QuantumInstruments/AccQCO2_1-1/AccQCO2_1-1_BoM.xlsx

Enervative AccQ CO2 Board BoM V1.1 - 2026-10-26
Designator | Quantity | Value | Footprint | Mount Type | PartNo | Manufacturer | Description | Comments
C1, C3, C9, C10, C11 | 5 | 100nF 50V X7R | C_0805_2012Metric_Pad1.18x1.45mm_HandSolder | smt |  | Generic | MLCC Capacitor X7R
C2 | 1 | 100nF 16V X7R | C_0402_1005Metric_Pad0.74x0.62mm_HandSolder | smt |  | Generic | MLCC Capacitor X7R | Note small footprint Part equivalent to Kyocera AVX KGM05AR71C104KN
C4, C5, C7 | 3 | 100uF 10V | CP_EIA-6032-28_Kemet-C_HandSolder | smt |  | Generic | Tantalum Capacitor | 10% or 20% Tolerance acceptable
C6, C8 | 2 | 100uF 6.3V | CP_EIA-3528-21_Kemet-B_HandSolder | smt |  | Generic | Tantalum Capacitor | 10% or 20% Tolerance acceptable
FB1 | 1 | 0.8A | R_0603_1608Metric | smt | MPZ1608S102ATA00 | TDK | Ferrite bead
J1 | 1 | RJ45 JACK | AMPHENOL_54602-908LF | tht | 54602-908LF | Amphenol | RJ45 connector, 8P8C w/o LED & Magnetics
J2 | 1 | Barrel_Jack_Switch | CUI_PJ-102 | tht | PJ-102A | Same Sky | DC Barrel Jack with an internal switch | China sourced equivalent OK
R1, R3 | 2 | 10K | R_1206_3216Metric_Pad1.30x1.75mm_HandSolder | smt |  | Generic | Resistor 1% 0.25W
R2, R4 | 2 | 110R | R_1206_3216Metric_Pad1.30x1.75mm_HandSolder | smt |  | Generic | Resistor 1% 0.25W
R5 | 1 | 1K | R_1206_3216Metric_Pad1.30x1.75mm_HandSolder | smt |  | Generic | Resistor 1% 0.25W
RN1 | 1 | 4 x 620R | R_Array_Convex_4x0603 | smt | YC164-JR-07620RL | Yageo | ±5% 62.5mW Power Per Element Isolated 4 Resistor Network | China sourced equivalent OK
U1 | 1 | PCA9615DP | TSSOP-10_3x3mm_P0.5mm | smt | PCA9615DPZ | NXP | Buffer, ReDriver 2 Channel 400kHz 10-TSSOP
U2 | 1 | SHT45-AD1F-R2 | SHT4X | smt | SHT45-AD1F-R2 | Sensirion | Digital Relative Humidity Temperature Sensor, ±1.0 %RH, ±0.1 °C, Ultra-Low-Power, with filtermembrane
U3 | 1 | TLV1117-33CKVURG3 | TO-252-2 | smt | TLV1117-33CKVURG3 | Texas | LDO 800mA Linear Regulator, Fixed Output, TO-252 | Alternative Parts: Diodes Incorporated: AZ1117D-3.3TRE1 STMicroelectronics: LD1117DT33TR or LD1117V33 ON Semiconductor: NCP1117DT33G
U4 | 1 | SCD43 | Sensirion_SCD4x-1EP_10.1x10.1mm_P1.25mm_EP4.8x4.8mm | smt | SCD43-D-R2 | Sensirion | Photoacoustic CO2 sensor, 40 000 ppm, I2C, 2.4-5.5 V, Base accuracy 400 - 2000 ppm
U5 | 1 | 256x8 ROM | IC_M24128-BFMH6TG | smt | M24C02-FMH6TG | ST Microelectronics | I2C Serial EEPROM, 2Kb, UFDFPN5
Total Parts | 25 |  | Total number of types | 16
Total SMT | 23 |  | Total SMT types | 14
Total THT | 2 |  | Total THT types | 2
