QuantumInstruments/AccQCO2_1-1/AccQCO2_1-1.kicad_pcb

## KiCad design AccQCO2_1-1.kicad_pcb (2026-10-29)

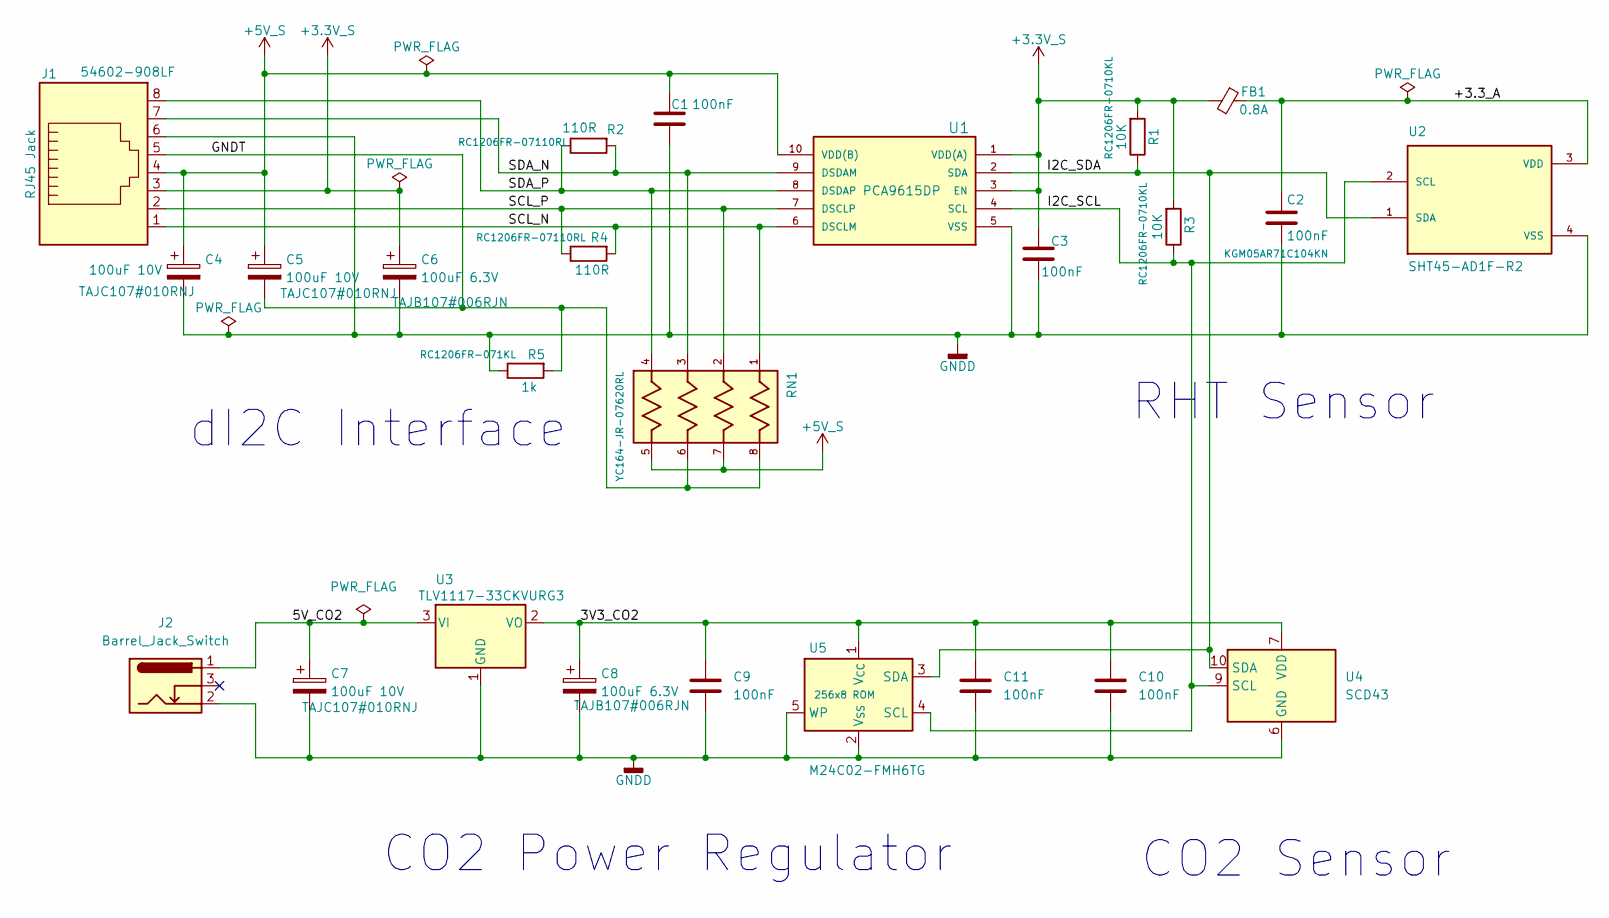
[picture p1: schematic AccQCO2_1-1.kicad_sch, AccQ CO2 Sensor]

Parts:
C1, C3, C9, C10, C11: 100nF; C_0805_2012Metric_Pad1.18x1.45mm_HandSolder
C2: 100nF; C_0402_1005Metric_Pad0.74x0.62mm_HandSolder; PartNo KGM05AR71C104KN
C4, C5, C7: 100uF 10V; CP_EIA-6032-28_Kemet-C_HandSolder; PartNo TAJC107#010RNJ
C6, C8: 100uF 6.3V; CP_EIA-3528-21_Kemet-B_HandSolder; PartNo TAJB107#006RJN
FB1: 0.8A; R_0603_1608Metric; PartNo MPZ1608S102ATA00
J1: RJ45 Jack; AMPHENOL_54602-908LF; PartNo 54602-908LF
J2: Barrel_Jack_Switch; CUI_PJ-102; PartNo PJ-102A
R1, R3: 10K; R_1206_3216Metric_Pad1.30x1.75mm_HandSolder; PartNo RC1206FR-0710KL
R2, R4: 110R; R_1206_3216Metric_Pad1.30x1.75mm_HandSolder; PartNo RC1206FR-07110RL
R5: 1k; R_1206_3216Metric_Pad1.30x1.75mm_HandSolder; PartNo RC1206FR-071KL
RN1: YC164-JR-07620RL; R_Array_Convex_4x0603; PARTREV 0
U1: PCA9615DP; TSSOP-10_3x3mm_P0.5mm; PartNo PCA9615DPZ
U2: SHT45-AD1F-R2; SHT4X; PartNo SHT45-AD1F-R2
U3: TLV1117-33CKVURG3; TO-252-2
U4: SCD43; Sensirion_SCD4x-1EP_10.1x10.1mm_P1.25mm_EP4.8x4.8mm; PartNo SHT45-AD1F-R2
U5: 256x8 ROM; IC_M24128-BFMH6TG; PartNo M24C02-FMH6TG

Connections:
+3.3V_S: C3.1, C6.1, FB1.2, J1.3, R1.2, R3.2, U1.1 (VDD(A)), U1.3 (EN)
+5V_S: C1.1, C4.1, C5.1, J1.4, RN1.5, RN1.7, U1.10 (VDD(B))
/3V3_CO2: C8.1, C9.1, C10.1, C11.1, U3.2 (VO), U4.7 (VDD), U4.19 (VDD), U5.1 (V_{CC})
/5V_CO2: C7.1, J2.1, U3.3 (VI)
/+3.3_A: C2.1, FB1.1, U2.3 (VDD)
/GNDT: C5.2, J1.5, R5.2, RN1.6, RN1.8
/I2C_SCL: R3.1, U1.4 (SCL), U2.2 (SCL), U4.9 (SCL), U5.4 (SCL)
/I2C_SDA: R1.1, U1.2 (SDA), U2.1 (SDA), U4.10 (SDA), U5.3 (SDA)
/SCL_N: J1.1, R4.2, RN1.1, U1.6 (DSCLM)
/SCL_P: J1.2, R4.1, RN1.2, U1.7 (DSCLP)
/SDA_N: J1.7, R2.2, RN1.3, U1.9 (DSDAM)
/SDA_P: J1.8, R2.1, RN1.4, U1.8 (DSDAP)
GNDD: C1.2, C2.2, C3.2, C4.2, C6.2, C7.2, C8.2, C9.2, C10.2, C11.2, J1.6, J2.2, R5.1, U1.5 (VSS), U2.4 (VSS), U3.1 (GND), U4.6 (GND), U4.20 (GND), U4.21 (GND), U5.2 (V_{SS}), U5.5 (WP)

Notes on the sheet:
dI2C Interface
RHT Sensor
CO2 Power Regulator
CO2 Sensor

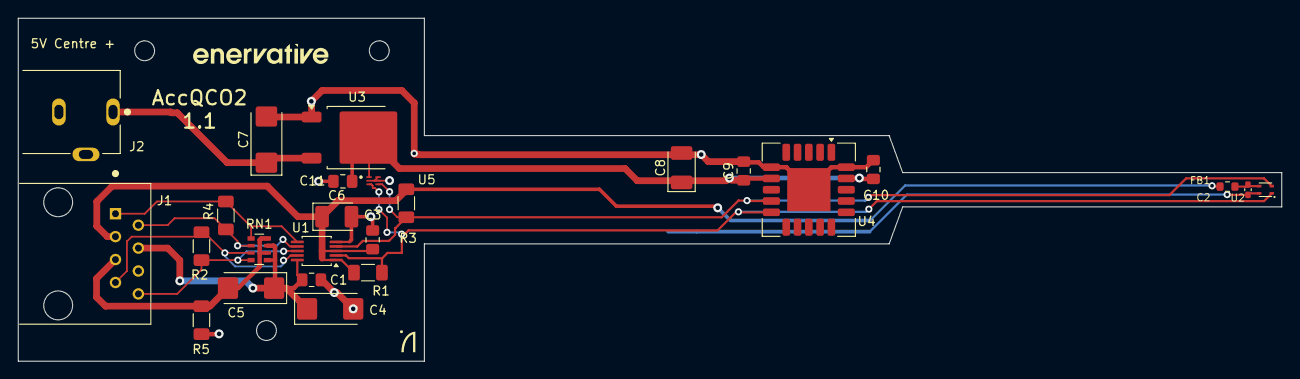
[picture p2: board AccQCO2_1-1.kicad_pcb from above]

Board: 2 copper layers, 140.0 x 38.0 mm, 29 parts (0 on the bottom side), 13 nets.

Other parts of the board:
L: LOGO; QI_logo2-5
MH1, MH1#2, MH3: MountingHole_2.2mm_M2
